knnurl/neric-triple-pendulum/CM7/Core/Src/main.c

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
/* Includes ------------------------------------------------------------------*/
#include "main.h"

/* USER CODE BEGIN Includes */
#include "shared_state.h"
#include "control_loop.h"
#include "odrive.h"
#include "pot_ctrl.h"
#include "as5047p.h"
#include "rail_limits.h"
#include "state_est.h"
/* USER CODE END Includes */

/* USER CODE BEGIN PD */

#ifndef HSEM_ID_0
#define HSEM_ID_0 (0U) /* HW semaphore 0*/
#endif
/* USER CODE END PD */

ADC_HandleTypeDef hadc1;

FDCAN_HandleTypeDef hfdcan1;

SPI_HandleTypeDef hspi1;

TIM_HandleTypeDef htim7;

void SystemClock_Config(void);
void PeriphCommonClock_Config(void);
static void MX_GPIO_Init(void);
static void MX_DMA_Init(void);
static void MX_FDCAN1_Init(void);
static void MX_TIM7_Init(void);
static void MX_ADC1_Init(void);
static void MX_SPI1_Init(void);
/* USER CODE BEGIN 0 */

/**
 * MPU: mark the 4 KB inter-core shared region (D2 SRAM3, section .shared_d2,
 * 0x30047000..0x30047FFF) as Normal NON-CACHEABLE, execute-never.
 *
 * Until 2026-07-11 no MPU region existed and g_shared coherency relied on
 * CM7's caches simply never being enabled — the ARMv7-M default memory map
 * makes 0x30000000 Normal/cacheable, so a future SCB_EnableDCache() would
 * have broken the heartbeat/command traffic systemically (M4 sees stale
 * m7_heartbeat -> WWDG2 reset loop). This region makes the contract
 * self-enforcing (arch review F9, fix-plan step 14).
 *
 * Cache policy after this change:
 *   - I-cache: SAFE to enable whenever wanted (instruction fetch only,
 *     no data-coherency exposure). Deliberately NOT enabled here — flip it
 *     in its own change with a bench pass, one unknown at a time.
 *   - D-cache: still needs its own audit first (FDCAN message RAM is
 *     Device memory and fine; confirm no DMA data buffers live in
 *     cacheable SRAM on CM7 at that point) + a dedicated bench pass.
 *
 * MPU_PRIVILEGED_DEFAULT keeps the default memory map as the background
 * for everything outside this region — nothing else changes.
 */
static void MPU_Config(void)
{
  MPU_Region_InitTypeDef r = {0};

  HAL_MPU_Disable();

  r.Enable           = MPU_REGION_ENABLE;
  r.Number           = MPU_REGION_NUMBER0;
  r.BaseAddress      = 0x30047000u;
  r.Size             = MPU_REGION_SIZE_4KB;
  r.SubRegionDisable = 0x00u;
  r.TypeExtField     = MPU_TEX_LEVEL1;              /* Normal memory ...    */
  r.IsCacheable      = MPU_ACCESS_NOT_CACHEABLE;    /* ... non-cacheable    */
  r.IsBufferable     = MPU_ACCESS_NOT_BUFFERABLE;
  r.IsShareable      = MPU_ACCESS_NOT_SHAREABLE;
  r.AccessPermission = MPU_REGION_FULL_ACCESS;
  r.DisableExec      = MPU_INSTRUCTION_ACCESS_DISABLE;
  HAL_MPU_ConfigRegion(&r);

  HAL_MPU_Enable(MPU_PRIVILEGED_DEFAULT);
}

/* USER CODE END 0 */

/**
  * @brief  The application entry point.
  * @retval int
  */
int main(void)
{

  /* USER CODE BEGIN 1 */
  /* Shared-region MPU protection before anything touches g_shared (and
   * before any future cache enable could matter). See MPU_Config above. */
  MPU_Config();
  /* USER CODE END 1 */
  /* MCU Configuration--------------------------------------------------------*/

  /* Reset of all peripherals, Initializes the Flash interface and the Systick. */
  HAL_Init();

  /* Configure the system clock */
  SystemClock_Config();

  /* Configure the peripherals common clocks */
  PeriphCommonClock_Config();
  /* Initialize all configured peripherals */
  MX_GPIO_Init();
  MX_DMA_Init();
  MX_FDCAN1_Init();
  MX_TIM7_Init();
  MX_ADC1_Init();
  MX_SPI1_Init();
  /* USER CODE BEGIN 2 */
  /* Initialise shared D2 SRAM and set m7_ready BEFORE releasing M4.
   * M4 spins on g_shared.m7_ready after HSEM_ID_0 release, so the
   * struct is guaranteed valid by the time M4 touches it. */
  SharedState_M7_Init();

  /* DWT cycle counter for control-loop overrun timing. */
  ControlLoop_Init();

  /* Debug GPIO: PE2 — scope confirms 5 kHz control loop rate */
  __HAL_RCC_GPIOE_CLK_ENABLE();
  GPIO_InitTypeDef dbg = {0};
  dbg.Pin   = GPIO_PIN_2;
  dbg.Mode  = GPIO_MODE_OUTPUT_PP;
  dbg.Pull  = GPIO_NOPULL;
  dbg.Speed = GPIO_SPEED_FREQ_VERY_HIGH;
  HAL_GPIO_Init(GPIOE, &dbg);

  /* ETH_CODE: fixed core synchronization
   * Release M4 core after GPIO and peripherals init
   * to avoid conflict.
   */
  __HAL_RCC_HSEM_CLK_ENABLE();
  HAL_HSEM_FastTake(HSEM_ID_BOOT_SYNC);
  HAL_HSEM_Release(HSEM_ID_BOOT_SYNC, 0);

  /* Bring up the ODrive CAN link. Configures FDCAN1 filter, starts the bus,
   * enables RX FIFO0 interrupt, waits for the first heartbeat. If the
   * heartbeat does not arrive within the boot window, Odrive_Init sets the
   * M7_FAULT_ODRIVE_HB_LOST bit in g_shared.m7_fault_flags. We still start
   * the control loop so M4 can see the fault — the loop body will send
   * Set_Input_Vel(0) until the link recovers. */
  (void)Odrive_Init();

  /* AS5047P encoders: CS lines idle high, prime the pipelined read chain. */
  AS5047P_Init();

  /* Rail end-switch GPIO/EXTI + hard-limit supervisor state (inert until
   * RAIL_HOME_SWITCH_WIRED is set; sw limits need a Home first anyway). */
  RailLimits_Init();

  /* State estimator: theta_dot low-pass coefficients. Estimates start
   * flowing on the first 1 kHz control-loop tick; theta needs a Zero θ
   * (upright capture) each boot before balance can arm. */
  StateEst_Init();

  /* Button/pot/LED GPIO + state machine init. ADC1 already inited by
   * MX_ADC1_Init above. pot_ctrl owns PC13 (button), PA3 (pot via ADC1),
   * PB0/PE1/PB14 (LEDs). */
  PotCtrl_Init();

  /* Start the 5 kHz bare-metal control loop. From this point TIM7_IRQHandler
   * fires every 200 us at preempt priority 0; the main loop below dispatches
   * button/pot ticks at ~10 ms cadence. */
  ControlLoop_Start();
  /* USER CODE END 2 */

  /* Infinite loop */
  /* USER CODE BEGIN WHILE */
  while (1)
  {
    /* USER CODE END WHILE */

    /* USER CODE BEGIN 3 */
    PotCtrl_Tick();
    HAL_Delay(10);   /* 100 Hz cadence for button/pot processing */
  }
  /* USER CODE END 3 */
}

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
/* USER CODE BEGIN 4 */

/**
 * @brief Period elapsed callback. Weak symbol override; called by the HAL
 *        from any TIM_BASE update IRQ. We dispatch by instance.
 *        TIM7 carries the bare-metal control loop at 5 kHz.
 */
void HAL_TIM_PeriodElapsedCallback(TIM_HandleTypeDef *htim)
{
    if (htim->Instance == TIM7) {
        ControlLoop_Tick();
    }
}

/* USER CODE END 4 */
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
