knnurl/neric-triple-pendulum/H7_M4ETH_ODriveMatlab.ioc

Mcu.UserName=STM32H745ZITx
PA1.Signal=ETH_REF_CLK
PA11.Signal=USB_OTG_FS_DM
PA12.Signal=USB_OTG_FS_DP
PA2.Signal=ETH_MDIO
PA3.Signal=ADCx_INP15
PA5.Signal=SPI1_SCK
PA6.Signal=SPI1_MISO
PA7.Signal=ETH_CRS_DV
PA8.Signal=USB_OTG_FS_SOF
PA9.Signal=USB_OTG_FS_VBUS
PB0.GPIO_Label=LD1 [Green Led]
PB0.Signal=GPIO_Output
PB13.Signal=ETH_TXD1
PB14.GPIO_Label=LD3 [Red Led]
PB14.Signal=GPIO_Output
PC1.Signal=ETH_MDC
PC13.GPIO_Label=B1 [Blue PushButton]
PC13.Signal=GPIO_Input
PC4.Signal=ETH_RXD0
PC5.Signal=ETH_RXD1
PD0.Signal=FDCAN1_RX
PD1.Signal=FDCAN1_TX
PD10.GPIO_Label=USB_OTG_FS_PWR_EN
PD10.Signal=GPIO_Output
PD14.GPIO_Label=ENC_CS0
PD14.Signal=GPIO_Output
PD15.GPIO_Label=RAIL_HOME_SW
PD15.Signal=GPIO_Input
PD5.Signal=USART2_TX
PD6.Signal=USART2_RX
PD7.Signal=SPI1_MOSI
PD8.GPIO_Label=STLINK_RX
PD8.Signal=USART3_TX
PD9.GPIO_Label=STLINK_TX
PD9.Signal=USART3_RX
PE1.GPIO_Label=LD2 [Yellow Led]
PE1.Signal=GPIO_Output
PE11.GPIO_Label=RAIL_END_SW
PE11.Signal=GPXTI11
PG11.Signal=ETH_TX_EN
PG13.Signal=ETH_TXD0
PG7.GPIO_Label=USB_OTG_FS_OVCR
PG7.Signal=GPXTI7
