knnurl/neric-triple-pendulum/(commit log)

2026-07-13 Initial public release: NERIC Triple Inverted Pendulum
    Dual-core STM32H745 + ODrive S1 cart-pole balancer. Stage-1 firmware
    (estimator, LQR balance, energy swing-up, on-rig system identification,
    1 kHz logging) on the M7 real-time core; Ethernet/UART/CAN communications
    on the M4 core; MATLAB fit/design toolchain; ESP32-S3 touch console.
    [H7_M4ETH_ODriveMatlab.ioc, as5047p.c, as5047p.h, balance_ctrl.c, balance_ctrl.h, control_input.h, control_loop.c, control_loop.h]
2026-07-14 Rail end-switch redesign (3-switch) + GUI live cart-follow; add README pin map
    Firmware (CM7):
    - Rail switches now three, two roles: home-end hard limit PD15, far-end hard
    limit PE11 (both EXTI15_10, cut power + latch, always armed), plus an inboard
    polled homing-reference switch PE13 that sets rail zero. Decouples homing
    from the hard limits (removes the s_homing home-switch suppression).
    - Level-confirm in the EXTI handler + boot pending-clear (no boot latch).
    - Home-end pin history PG2/PG3 -> PE9 -> PF14 -> PD15; far briefly tried PF12.
    PE9/PF14/PF12 could not be pulled low on this board (SWD-confirmed).
    GUI (matlab/pendulum_gui.m):
    - Position slider now tracks the live cart posi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
    [H7_M4ETH_ODriveMatlab.ioc, main.c, main.h, rail_limits.c, rail_limits.h]
